gnuoyohes/SafeWater/README.md

# Project SafeWater
## Seho Young
### Advisor: Dr. Alan Kaplan
